supermileage/dynamometer-pcb/data/74HC4052/74HC4052.step

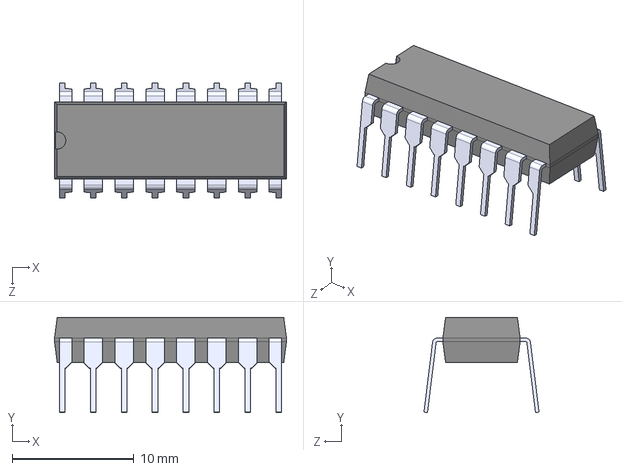
[picture p1: CAD file, 2023-05-04]
data/74HC4052/74HC4052.step
19.0 x 7.80 x 9.44 mm
