supermileage/dynamometer-pcb/data/LP11EE1NCSYG/LP11EE1NCSxx.stp

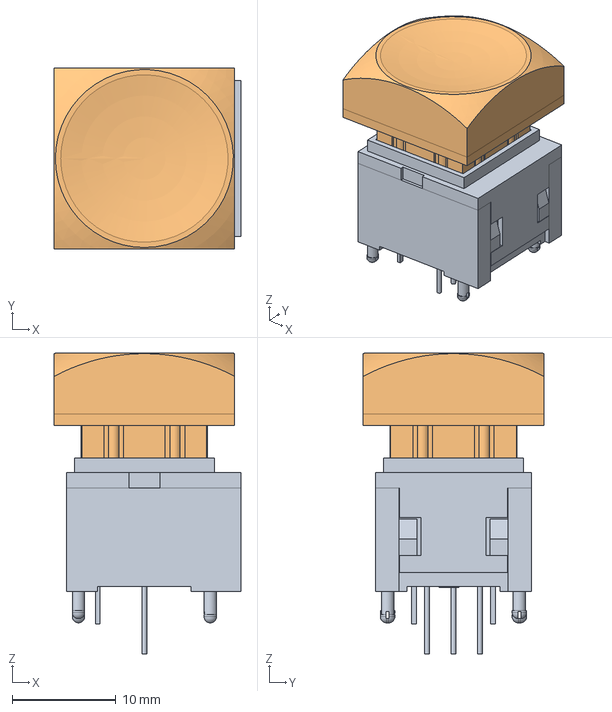
[picture p2: CAD file, 2023-02-23]
data/LP11EE1NCSYG/LP11EE1NCSxx.stp
18.0 x 17.4 x 29.0 mm
