supermileage/dynamometer-pcb/Dyno22.kicad_pcb

## KiCad design Dyno22.kicad_pcb (2024-02-17)

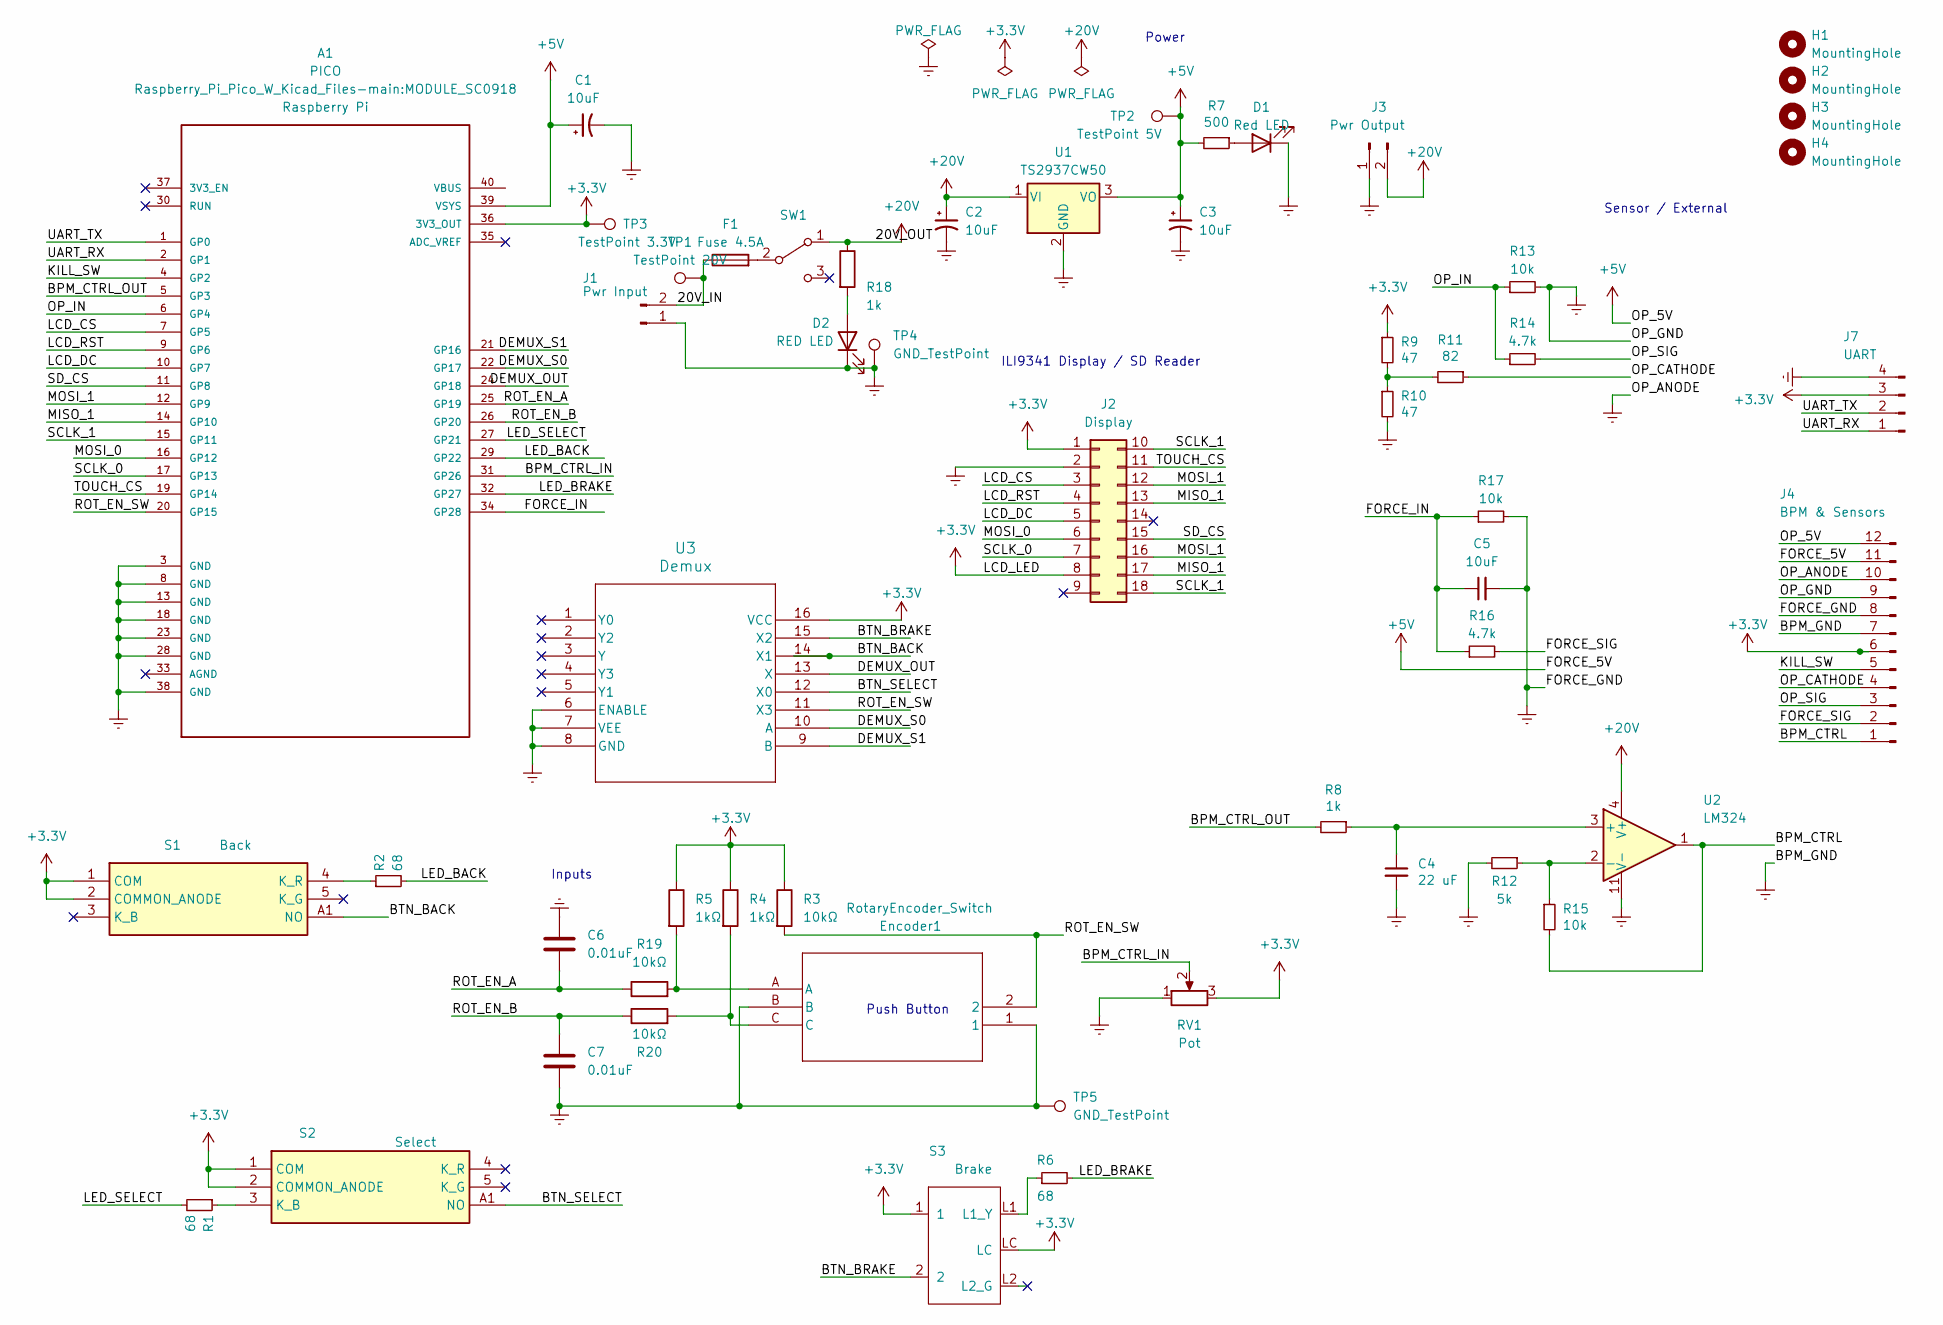
[picture p3: schematic Dyno22.kicad_sch]

Parts:
A1: PICO; MODULE_SC0918; PARTREV 1.6
C1, C3: 10uF; C_1206_3216Metric
C2: 10uF; CAP_293D-C_VSS
C4: 22 uF; C_0805_2012Metric
C5: 10uF; C_0805_2012Metric
C6, C7: 0.01uF; C_0603_1608Metric
D1: Red LED; LED_0805_2012Metric
D2: RED LED; LED_0805_2012Metric
Encoder1: RotaryEncoder_Switch; TO_215F-S0024
F1: Fuse 4.5A; Fuse_1206_3216Metric
H1, H2, H3, H4: MountingHole; MountingHole_3.2mm_M3
J1: Pwr Input; Molex_Nano-Fit_105313-xx02_1x02_P2.50mm_Horizontal
J2: Display; ILI9351_Large_Display
J3: Pwr Output; Molex_Nano-Fit_105313-xx02_1x02_P2.50mm_Horizontal
J4: BPM & Sensors; Molex_Nano-Fit_105314-xx12_2x06_P2.50mm_Horizontal
J7: UART; Molex_Nano-Fit_105314-xx04_2x02_P2.50mm_Horizontal
R1, R2, R6: 68; R_0805_2012Metric
R3, R19, R20: 10kΩ; R_0805_2012Metric
R4, R5: 1kΩ; R_0805_2012Metric
R7: 500; R_0805_2012Metric
R8, R18: 1k; R_0805_2012Metric
R9, R10: 47; R_0805_2012Metric
R11: 82; R_0805_2012Metric
R12: 5k; R_0805_2012Metric
R13, R15, R17: 10k; R_0805_2012Metric
R14, R16: 4.7k; R_0805_2012Metric
RV1: Pot; Potentiometer_Vishay_148-149_Single_Vertical
S1: Back; KP0115ANBKG03RGBP3SJB; Mouser Part Number 633-5ANBKG03RGBP3SJB
S2: Select; KP0115ANBKG03RGBP3SJB; Mouser Part Number 633-5ANBKG03RGBP3SJB
S3: Brake; LP11EE1NCSYG
SW1: SW_DPST_x2; SW_300SP1J1BLKM2QE
TP1: TestPoint 20V; TestPoint_Plated_Hole_D2.0mm
TP2: TestPoint 5V; TestPoint_Plated_Hole_D2.0mm
TP3: TestPoint 3.3V; TestPoint_Plated_Hole_D2.0mm
TP4, TP5: GND_TestPoint; TestPoint_Plated_Hole_D2.0mm
U1: TS2937CW50; SOT-223-3_TabPin2
U2: LM324; DIP-14_W7.62mm
U3: Demux; SOIC-16WB_ONS

Connections:
+3.3V: A1.36 (3V3_OUT), J2.1, J2.8, J4.6, J7.3, R3.1, R4.1, R5.1, R9.1, RV1.3, S1.1 (COM), S1.2 (COMMON_ANODE), S2.1 (COM), S2.2 (COMMON_ANODE), S3.1, S3.LC, TP3.1, U3.16 (VCC); also elsewhere on the board
+5V: A1.39 (VSYS), C1.1, C3.1, J4.11, J4.12, R7.2, TP2.1, U1.3 (VO)
+24V: C2.1, J3.2, R18.1, SW1.1 (A), U1.1 (VI), U2.4 (V+); also elsewhere on the board
/20V_IN: F1.1, J1.2, TP1.1
/BPM_CTRL: J4.1, R15.2, U2.1
/BPM_CTRL_IN: A1.31 (GP26), RV1.2
/BPM_CTRL_OUT: A1.5 (GP3), R8.2
/BTN_BACK: S1.A1 (NO), U3.14 (X1); also elsewhere on the board
/BTN_BRAKE: S3.2, U3.15 (X2)
/BTN_SELECT: S2.A1 (NO), U3.12 (X0); also elsewhere on the board
/DEMUX_OUT: A1.24 (GP18), U3.13 (X)
/DEMUX_S0: A1.22 (GP17), U3.10 (A)
/DEMUX_S1: A1.21 (GP16), U3.9 (B)
/FORCE_IN: A1.34 (GP28), C5.1, R16.1, R17.1
/FORCE_SIG: J4.2, R16.2
/KILL_SW: A1.4 (GP2), J4.5
/LCD_CS: A1.7 (GP5), J2.3
/LCD_DC: A1.10 (GP7), J2.5
/LCD_RST: A1.9 (GP6), J2.4
/LED_BACK: A1.29 (GP22), R2.2
/LED_BRAKE: A1.32 (GP27), R6.2
/LED_SELECT: A1.27 (GP21), R1.2
/MISO_1: A1.14 (GP10), J2.13, J2.17
/MOSI_0: A1.16 (GP12), J2.6
/MOSI_1: A1.12 (GP9), J2.12, J2.16
/OP_CATHODE: J4.4, R11.1
/OP_IN: A1.6 (GP4), R13.1, R14.1
/OP_SIG: J4.3, R14.2
/ROT_EN_A: A1.25 (GP19), C6.2, R19.1
/ROT_EN_B: A1.26 (GP20), C7.1, R20.1
/ROT_EN_SW: A1.20 (GP15), Encoder1.2, R3.2, U3.11 (X3); also elsewhere on the board
/SCLK_0: A1.17 (GP13), J2.7
/SCLK_1: A1.15 (GP11), J2.10, J2.18
/SD_CS: A1.11 (GP8), J2.15
/TOUCH_CS: A1.19 (GP14), J2.11
/UART_RX: A1.2 (GP1), J7.1
/UART_TX: A1.1 (GP0), J7.2
Earth: A1.3 (GND), A1.8 (GND), A1.13 (GND), A1.18 (GND), A1.23 (GND), A1.28 (GND), A1.38 (GND), C1.2, C2.2, C3.2, C4.2, C5.2, C6.1, C7.2, D1.1 (K), D2.1 (K), Encoder1.1, Encoder1.B, J1.1, J2.2, J3.1, J4.7, J4.8, J4.9, J4.10, J7.4, R10.2, R12.2, R13.2, R17.2, RV1.1, TP4.1, TP5.1, U1.2 (GND), U2.11 (V-), U3.6 (ENABLE), U3.7 (VEE), U3.8 (GND); also elsewhere on the board
unnamed: D1.2 (A), R7.1
unnamed: D2.2 (A), R18.2
unnamed 40: Encoder1.A, R5.2, R19.2; also elsewhere on the board
unnamed 41: Encoder1.C, R4.2, R20.2; also elsewhere on the board
unnamed: R9.2, R10.1, R11.2
unnamed 43: R2.1, S1.4 (K_R); also elsewhere on the board
unnamed 44: R1.1, S2.3 (K_B); also elsewhere on the board
unnamed: R6.1, S3.L1 (L1_Y)
unnamed 46: F1.2, SW1.2 (B); also elsewhere on the board
unnamed: C4.1, R8.1, U2.3 (+)
unnamed: R12.1, R15.1, U2.2 (-)

Notes on the sheet:
Power
Push Button
Sensor / External
ILI9341 Display / SD Reader
Inputs

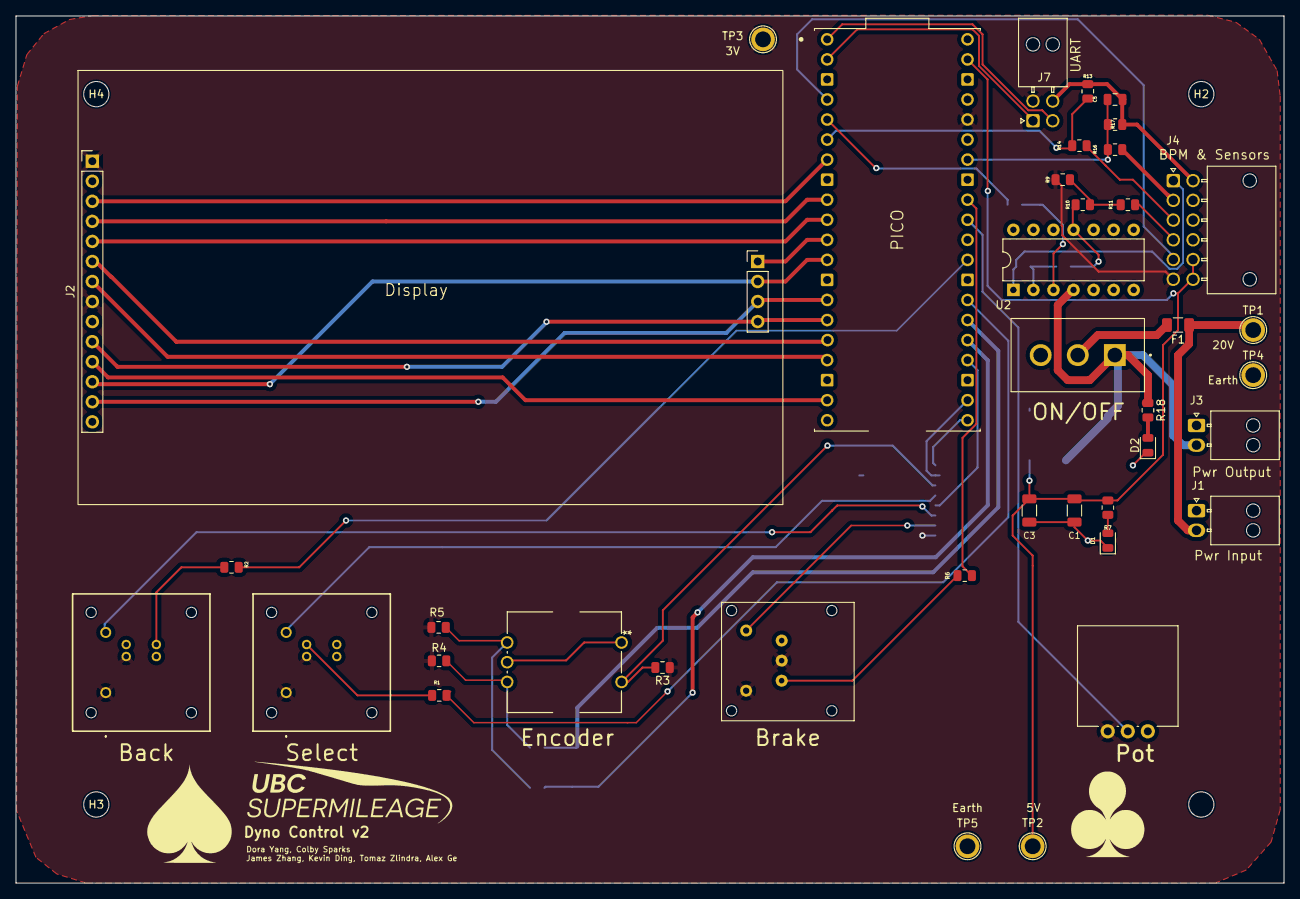
[picture p4: board Dyno22.kicad_pcb from above]

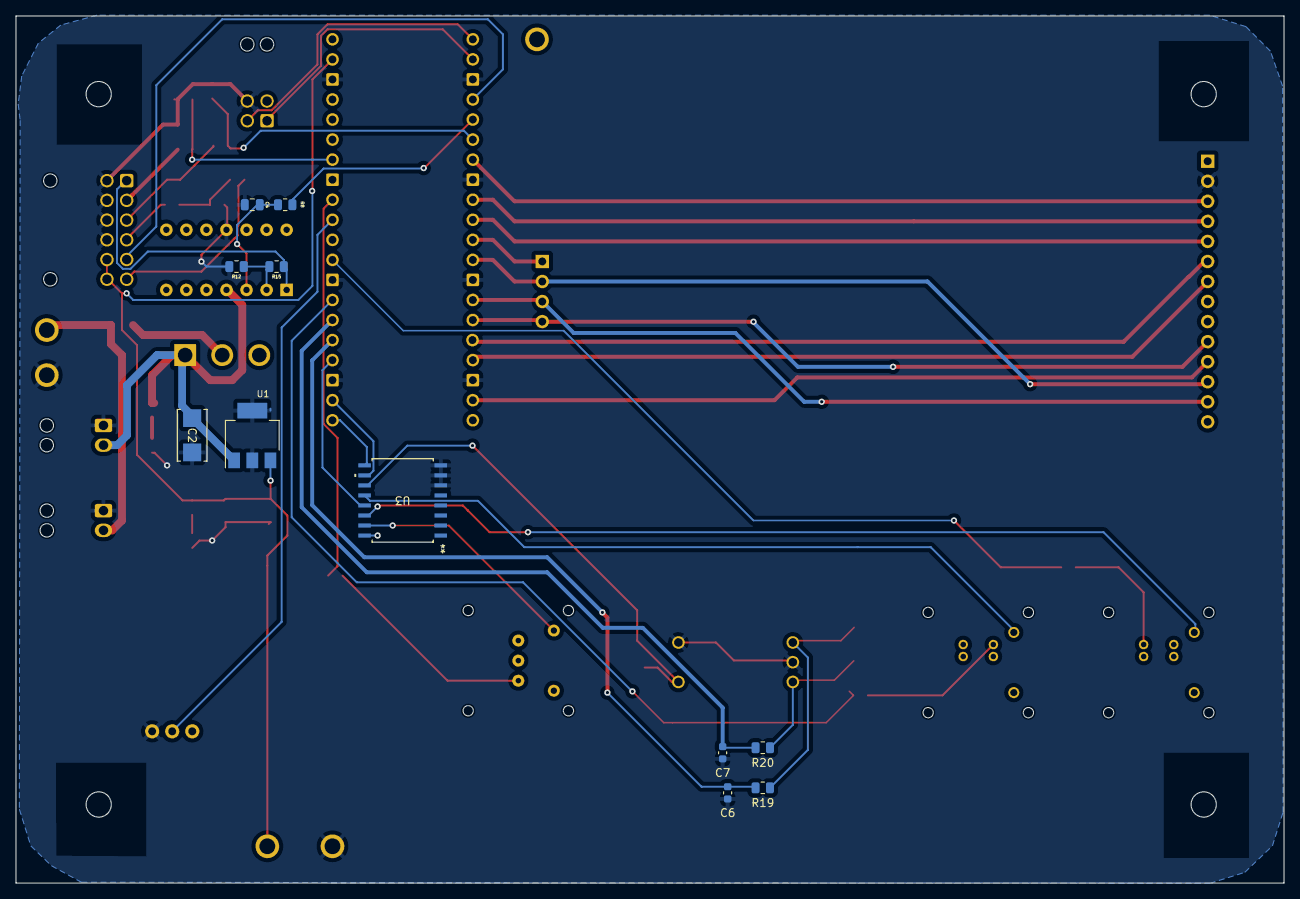
[picture p5: board Dyno22.kicad_pcb from below]

Board: 2 copper layers, 160.7 x 109.9 mm, 55 parts (11 on the bottom side), 49 nets.

Other parts of the board:
Back: Back; KP0115ANBKG03RGBP3SJB
Encoder: RotaryEncoder_Switch; TO_215F-S0024
GW: LOGO
ON/OFF: SW_DPST_x2; SW_300SP1J1BLKM2QE
Select: Select; KP0115ANBKG03RGBP3SJB

Their connections:
+3.3V: Back.1 (COM), Back.2 (COMMON_ANODE), Select.1 (COM), Select.2 (COMMON_ANODE); also elsewhere on the board
+24V: ON/OFF.1 (A); also elsewhere on the board
/BTN_BACK: Back.A1 (NO); also elsewhere on the board
/BTN_SELECT: Select.A1 (NO); also elsewhere on the board
/ROT_EN_SW: Encoder.2; also elsewhere on the board
Earth: Encoder.1, Encoder.B; also elsewhere on the board
unnamed 40: Encoder.A; also elsewhere on the board
unnamed 41: Encoder.C; also elsewhere on the board
unnamed 43: Back.4 (K_R); also elsewhere on the board
unnamed 44: Select.3 (K_B); also elsewhere on the board
unnamed 46: ON/OFF.2 (B); also elsewhere on the board
