supermileage/dynamometer-pcb/(threads)

Thread 1 (2023-02-17):

Update Schematic for rpi pico w

cosparks, 2023-02-17:
Update old schematic with non replaced with symbol raspberry pi pico, which runs on 3.3V instead of 5V.

### Available Pins
- we need to use GP4, GP5 (for i2c), GP16-GP21 (ili), and GP10-15 (spi1)

### Outward-Facing Connectors
- 20V input (3.3V distributed to board, 10V to op-amp)
- 20V output
- BPM control-voltage 0-10V
- force sensor
- optical sensor pins
- i2c (pins GP4, GP5, 3v3 and GND)

### Internal
- GP16-21 for ILI9341 display (https://www.aliexpress.com/item/1005004226615977.html)
- GP10-14 for ILI9341 sd card reader
- pwm output to opamp (all pico GP pins have pwm)
- EC11 rotary encoder (any available pins)
- 3 buttons (2 https://www.digikey.ca/en/products/detail/e-switch/LP11OA1TCSYY/4028417 and one https://www.digikey.com/en/products/detail/e-switch/LP11EE1NCSYG/9771935)

cosparks, 2023-02-17:
[pico PIO instructions](https://rp2040pio-docs.readthedocs.io/en/latest/pio-programs.html)

cosparks, 2023-02-21:
This issue has been turned into a milestone

Closed 2023-05-19.

Thread 2 (2023-02-17):

Dyno Controller PCB

cosparks, 2023-02-17:
## Layout
### Major component sizes
- ILI3941 Display is 55.04 x 89.3mm
- Latching button is 16.8 x 15mm
- Non-latching buttons are 15 x 15mm
- Rotary encoder is 11.7 x 11.7mm
- *proposed pcb dimensions*: 100 x 150mm

### Outward-Facing Connectors (from #1)
- All located at back (top edge) of board
- Screen SD card slot must be exposed, so display must also be aligned with top edge of board
- Force and optical sensor pins can be combined in one connector, rest can be separated (BPM control, i2c, 20V output)
- rpi pico w should be placed such that its usb connector is accessible either from the front, or front left/right corner of the board (see [urban steering PCB](https://github.com/supermileage/UrbanSteeringPCB) for reference)

### UI
- buttons can be placed in whichever way makes the most sense: I was thinking that the two non-latching buttons should be to the left of the rotary encoder, and the one latching button could be to the right
- *Note*: it's possible that this configuration may change: we might add more buttons

Closed 2023-05-19.

Thread 3 (2023-02-17):

Dyno Controller Case

cosparks, 2023-02-17:
### Details
- parametric dyno controller case using fusion360
- slight tilt from front of case to back
- *PCB dimensions*: 100 x 150 mm
- clear acrylic layer on top with holes for touch-screen display, rotary encoder and buttons

Closed 2023-05-19.

Thread 4 (2023-02-21):

Test Force Sensor w/ 3.3V power supply

cosparks, 2023-02-21:
If it cannot operate at a lower power supply then we will have to scale 0.5-5V signal to 0.3-3.3V

cosparks, 2023-02-24:
Added voltage divider circuit to schematic.

Closed 2023-02-24.

Thread 5 (2023-02-21):

Test EC11 Rotary Encoder

cosparks, 2023-02-21:
Add rotary encoder circuit to dyno control board schematic

cosparks, 2023-03-05:
@dorayang I've assigned this to you.  can be finished next weekend

Closed 2023-05-19.

Thread 6 (2023-02-21):

Update Brake Power Module Circuit

cosparks, 2023-02-21:
We will switch to using 3.3V pwm signal from the pico.  Update BPM op-amp circuit if necessary

Closed 2023-02-22.

Thread 7 (2023-02-21):

Update Optical Sensor Circuit

cosparks, 2023-02-21:
We can provide 5V output to OPB917, but OP_IN 5V logic level needs to be shifted to 3.3V

cosparks, 2023-02-21:
Added 4.7k -> 10k voltage divider circuit to schematic

Closed 2023-02-21.

Thread 11 (2023-02-24):

Find suitable potentiometer

cosparks, 2023-02-24:
Buttons and rotary encoder have height of ~24mm and base of 15x15mm.  Find a potentiometer with similar dimensions.  And link its footprint to the potentiometer in the schematic

cosparks, 2023-02-24:
this high-torque potentiometer looks ideal but is a bit expensive

https://www.digikey.ca/en/products/detail/vishay-sfernice/P11H1F0GHFW10103MA/16032840

cosparks, 2023-02-24:
very cheap, but low torque option:

https://www.digikey.ca/en/products/detail/bourns-inc/PTV09A-4220F-B103/3781150

Closed 2023-05-19.

Thread 12 (2023-02-24):

Remove pull-down resistors from buttons

cosparks, 2023-02-24:
rp2040 has optional pull-up and pull-down resistors on each gpio pin, so there is no need for pull-down resistors.

Closed 2023-05-19.

Thread 14 (2023-05-19):

Fix Rotary Encoder Footprint

cosparks, 2023-05-19:
Rotary encoder footprint for v1.0 is too small
- pin spacing is smaller than 2.54mm and courtyard diameter is off by ~5mm
- either redesign dyno control board with new footprint, or mini rotary encoder adapter for current footprint

cosparks, 2023-08-11:
We have additional rotary encoders which aren't already soldered into breakout boards.  I think they would require some pull-up resistors but that is it.  This is worth investigating as they are cheaper than the breakout board ones.

Closed 2023-11-11.

Thread 15 (2023-05-19):

Fix LCD Display Footprint

cosparks, 2023-05-19:
LCD does not fit perfectly in its socket header.  SD Card Header needs to be moved ~0.5mm down (towards rotary encoder) from current placement.  The pins/screen have some flexibility so the display does fit into the headers, but it could be improved.

cosparks, 2023-05-26:
I'm actually no so sure of this.  The second LCD I plugged into the board did not have to be contorted in any way to get it to fit, so it could have been an issue with the first display I tried to plug in.

Closed 2023-10-03.

Thread 16 (2023-05-19):

Consecutive pins for rotary encoder

cosparks, 2023-05-19:
Unfortunately, only neighbouring (consecutive pins) can be used for the pico's rotary encoder input.
- for PCB v2.0 ROT_EN_A and ROT_EN_B need to be consecutive

JamesZhZhang, 2023-10-28:
Note to self that the pin assignments in the firmware will have to change too

cosparks, 2023-10-28:
the current display driver that this project uses already makes use of the second pio module (I switched to that new driver this summer), so pio is no longer an option for rotary encoder.  Fortunately, it runs very smoothly from the main control loop so shouldn't need its own pio module.

That's not to say that the pins shouldn't be made consecutive, just to leave the option open in case rotary encoder performance deteriorates as the firmware grows in complexity and you decide at some point in the future reclaim that pio module.

JamesZhZhang, 2023-11-04:
Thanks for the reply @cosparks! I'm just having trouble interpreting what you mean, as I'm still trying to wrap my head around the codebase as a whole. What's the difference between the second pio module, and the main control loop here?

cosparks, 2023-11-05:
The rp2040 (mcu for rpi pico) has 2 programmable input/output modules which run independently of the main processor cores (although they run on the same clock).  [Here's](https://www.raspberrypi.com/news/what-is-pio/) a simple tldr.  More info in chapter 3 of the [rp2040 datasheet](https://datasheets.raspberrypi.com/rp2040/rp2040-datasheet.pdf).

Essentially, they allow you to write small programs (4 states each, and up to 32 assembly instructions per state) which can read and write to IO pins, and which can read and write data from the main cores using pico SDK functions.  You could write a PIO program which implements SPI, UART, CAN or some other communication protocol, for instance.

A really simple example would be the encoder program I wrote to count pulses the optical sensor pin [here](https://github.com/supermileage/dynamometer-firmware/blob/dev/src/PIO/pio_counter.pio), (which compiles to [this](https://github.com/supermileage/dynamometer-firmware/blob/dev/src/PIO/pio_counter_program.pio.h)).  You can see how we request data from that module in `SensorOptical::handle` [here](https://github.com/supermileage/dynamometer-firmware/blob/be151549e00a9ec12d626ddecfb0c235b8330257/src/Sensor/SensorOptical.cpp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).

The original plan was to use one module to read the optical sensor, and the other to handle the rotary encoder.  It was a mistake that the pins on the rotary encoder weren't placed consecutively, but this summer I switched from our old tft display driver to a new one which uses the second PIO module, so both have been claimed!  At least for now

JamesZhZhang, 2023-11-07:
Thanks for the explanation! I understand the implentation of the PIO now 😄

Just wanted to clarify what's currently implemented in the code. So the rotary encoder uses pins on the pico that correspond to the main control loop (i.e. no changes need to be made to the code, unless I change the pin assignments of the rotary encoder on the PCB?)

cosparks, 2023-11-07:
> Just wanted to clarify what's currently implemented in the code. So the rotary encoder uses pins on the pico that correspond to the main control loop

yep!  the rotary encoder pins are being handled by the input manager in the main control loop.

The decision on whether or not to change those pins is up to you, but I'd recommend it.  It would be a very small change in the code and would make the design a bit more flexible in case things change in the future

cosparks, 2023-11-07:
oops didn't mean to press close with comment haha

JamesZhZhang, 2023-11-07:
Gotcha, thanks so much for taking the time to explain all this to me! I'll go forward with making the pins consecutive for now, and probably add a comment in the code for the rotary encoder pin assignment for future reference. Best of luck with your capstone!

Closed 2024-01-21.

Thread 17 (2023-05-20):

Fix potentiometer footprint

cosparks, 2023-05-20:
The through-holes on the right side of footprint are too far apart vertically.  It seems like they should be within the bounds of, and not centred at the corners of the courtyard.
- holes probably need to be brought in ~1mm towards the center of the courtyard

The potentiometer's mounting supports can be bent so that they fit the current design, so this is not a deal-breaker

KevinZhiyuanDing, 2023-10-28:
https://github.com/supermileage/dynamometer-pcb/commit/03d35e74a3f1db1f3750efc926a0eced5b3e5ced

cosparks, 2023-10-28:
@KevinZhiyuanDing I still get notifications for this repo so saw that you are working on this.

I forgot to add that the potentiometer footprint also should be rotated 90° counter-clockwise, so the nob sits in the correct position when it's zeroed.  I'm not sure if knobs for d-shaft pots are standardized, but all the ones that I checked out at lee's electronics were the same.

this is zero (closed)
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
but this should be zero:
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

And to fully open the pot you rotate clockwise 270°

Closed 2023-11-11.

Thread 18 (2023-05-20):

Increase size of silkscreen labels for buttons and connectors

cosparks, 2023-05-20:
- current size is only legible from very close -- should be double or triple the current size

KevinZhiyuanDing, 2023-11-18:
Label dimensions for buttons and connectors changed for height and width
from 1.0 mm to 1.5 mm
or
from 0.8 mm to 1.2mm

Closed 2024-02-12.

Thread 19 (2023-05-21):

More space for potentiometer

cosparks, 2023-05-21:
With everything mounted on the board, it is apparent that the spacing of the potentiometer and brake button isn't optimal.
- sensor caps and resistors can be moved to bottom of board to bottom of board
- bottom-right silkscreen label can be moved and pico can farther down in the bottom right corner

KevinZhiyuanDing, 2023-11-18:
@cosparks I moved the potentiometer down and the rotary encoder to the right slightly to make it less cramped. Could you clarify how the Pico can be moved further down because there is a mounting point in the way. Here are the changes I made so far:
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
I also increased the text label size on the silk screen.
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

cosparks, 2023-11-18:
looks awesome!  You could move the pico down a tiny bit without moving that mounting hole, or you could move the mounting hole so it sits to the left of the pico and move the pico all the way down so it's almost flush with the corner.  The second option would require a small redesign to the case.

Aesthetically, neither option is great, as the buttons and rotary encoder will no longer be aligned with the pico, but that probably doesn't matter that much

cosparks, 2023-11-18:
If it's going to be out of alignment anyways, I think I would prefer the second option.

LaPommeCosmique, 2023-11-20:
That makes sense. Just wondering, what would you say would be an acceptable distance for the potentiometer and the brake button? Its harder for me to visualize everything mounted on the board as we don't have a potentiometer knob.

cosparks, 2023-11-20:
It kinda looks like the brake button should come down maybe a couple millimetres, and then the potentiometer should be centred between it and the pico.  Currently it's 11m between pot and brake button, but I'd add at least 4mm so there is >=15mm between the two.

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

cosparks, 2023-11-20:
I should really drop off this board and case so you guys have it

LaPommeCosmique, 2023-11-20:
I see what you mean now. I wonder if we can just remove the brake button all together, and replace the potentiometer with one that has a click at 0. Aesthetically there's less clutter and I don't think we lose any functionality. We can also have something like an LED that signals whether the brake is receiving power.

cosparks, 2023-11-20:
A couple thoughts on that.
1. It's nice to have a latching button for UI stuff: brake button is already being used for editing filenames in the text dialog editor (in this context, it performs the same function as the rotary encoder switch, but I've found it's a much nicer option because holding down the encoder switch to edit characters is kind of annoying).  I don't think a potentiometer switch would be as intuitive or useful
2. It might be hard to find a high-torque option with a switch (although I'm not sure whether or not you still want a high torque potentiometer on board)

Closed 2024-01-21.

Thread 20 (2023-07-09):

Add on/off switch to board

cosparks, 2023-07-09:
Among other things, an on/off switch would make it easier to reset the controller.

Add to back or side.  Make sure it aligns with the case.

KevinZhiyuanDing, 2023-11-18:
@cosparks Hey Colby, would it be okay if we implement the switch externally instead of on the board itself, adding an on off switch between the power source and the power input.

cosparks, 2023-11-18:
> @cosparks Hey Colby, would it be okay if we implement the switch externally instead of on the board itself, adding an on off switch between the power source and the power input.

that sounds like a very good solution!

cosparks, 2023-11-18:
Only advantage that I can think of for having it on the board is that it would be more accessible, and could be used with any power supply.

KevinZhiyuanDing, 2023-11-25:
Ok thanks. Alex, James and I are weighting the options

Closed 2024-01-21.

Thread 23 (2023-11-26):

Move LCD pins and PICO pins closer together

JamesZhZhang, 2023-11-26:
Sara mentioned that theres a large number of traces going from the LCD to the PICO, and cover a large distance. This is effectively splitting the front copper plane. She recommended moving the LCD down (where the buttons and rotary encoder are) and also flipping it so the SD reader can be aligned with a face. She also recommended Moving the PICO to be more central

cosparks, 2023-11-26:
Note that the SD card slot in the LCD screen needs to remain accessible through the slit that I added to the dyno controller case.
The pico micro-usb connector also needs to be accessible so you can plug in through the side of the case (the original plan was to have an acrylic cover with button, potentiometer and rotary encoder holes cut: with this cover on, the pico wouldn't be accessible from the middle of the board).

It looks like there is a lot of room for stuff on the back copper, so you could instead add vias and run the traces along the back copper for part of their path.  Then you wouldn't have to rearrange anything.

cosparks, 2023-11-26:
> also flipping it so the SD reader can be aligned with a face.

The SD reader is aligned with the back face of the case

JamesZhZhang, 2023-11-26:
Yup we'll account for the SD card reader and PICO micro usb slot being on the edge of the board. We'll likely be making small modifications to the case and re-printing it if we go through with these changes. To centralize the PICO, we were thinking of possibly rotating it 90 degrees such that the micro usb is facing the top or bottom edge.

The reason why Sara wants to move the LCD and PICO closer is because the traces are effectively cutting the front copper in half right now. We'd see the same issue if we moved the traces to the back copper. Ideally we want the majority of traces to be as short as possible.

Closed 2024-01-21.

Thread 24 (2023-11-26):

Changes Trace for Quality of Life

JamesZhZhang, 2023-11-26:
Ensure there are no right angles and no junctions in the traces. Also ensure there are no large deadzones created by the traces

Closed 2024-02-12.

Thread 25 (2023-11-26):

Change Component Slikscreens

JamesZhZhang, 2023-11-26:
Change silkscreens such that it's only the designator (R1) and not the value (1k ohm), unless necessary to have the value.

Make sure designator silkscreens are outside the component footprint (so that the designator is still visible when the component is mounted

Closed 2024-02-17.

Thread 26 (2023-11-26):

Add Keep Out Zones for Mounting Holes

JamesZhZhang, 2023-11-26:
Add keep out zones for mounting holes. This is to prevent an electrical short from mounting with metal screws (currently we use plastic screws)

Closed 2024-01-21.

Thread 27 (2023-11-26):

Quality of Life Changes for Power

JamesZhZhang, 2023-11-26:
Add a fuse for the 24V line.

Add LEDs for the power lines to indicate power is flowing. (May also need to add a resistor for the diode)

Add 4 testpoints for 24V, 5V, 3.3V, EARTH. Recommended to be 4mm surface mount rectangular test points.

Closed 2024-01-21.

Thread 29 (2024-03-16):

Power PI Pico with 5V makes it output on VSYS and powers the entire 20V trace with 5V

LaPommeCosmique, 2024-03-16:
Power PI Pico with 5V makes it output on VSYS and powers the entire 20V trace with 5V.

As a result, the 20V LED turns on the pico is receiving power from the microUSB cable, even when there is no 20V supply going into the board.

Could add a diode or something here (suggested by @JamesZhZhang )

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

JamesZhZhang, 2024-03-16:
Following the datasheet, adding Schottky diode 'D' should fix this
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

Someone just needs to spec the correct Schottky diode based on the voltages here

(From pg 21 of pi pico datashewet https://datasheets.raspberrypi.com/pico/pico-datasheet.pdf)
