supermileage/dynamometer-pcb/(commit log)

2023-02-12 Adding Dyno KiCad Project Files
    [Dyno22.kicad_pcb, Dyno22.sch]
2023-02-21 Updates schematic to include pico w, lcd display and ui inputs
    [Dyno22.kicad_pcb, Dyno22.kicad_sch]
2023-02-21 Fixes some labels--adds new label for 20V input
    [Dyno22.kicad_sch]
2023-02-21 Adds 5 -> 3.3V conversion for force and optical sensors
    [Dyno22.kicad_sch]
2023-02-21 Adds voltage regulator to power input
    [Dyno22.kicad_sch]
2023-02-21 Adds connections for all button pins
    [Dyno22.kicad_sch]
2023-02-21 Fixes pin headers for lcd display
    [Dyno22.kicad_sch]
2023-02-22 Modifies op amp circuit -- 3.3V -> 10V pwm
    [Dyno22.kicad_sch]
2023-02-22 uart labels assigned to wrong pins
    [Dyno22.kicad_sch]
2023-02-23 Adds graphics to pcb
    [Dyno22.kicad_pcb, Dyno22.kicad_sch, LP11EE1NCSxx.stp]
2023-02-23 Adds wider traces and high-voltage capacitor to pwr circuit
    [Dyno22.kicad_pcb, Dyno22.kicad_sch]
2023-02-23 Rearranges components on pcb - final arrangement
    [Dyno22.kicad_pcb]
2023-03-11 Uploading changes to PCB and Schematic
    * Removed button pull down resistors
    * Updated rotary encoder and potentiometer footprints
    * Moved display (and minor layout changes of other components)
    * Added mounting holes to support rotary encoder
    [Dyno22.kicad_pcb, Dyno22.kicad_sch, Dyno22.sch]
2023-03-18 PCB Layout Done
    [Dyno22.kicad_pcb]
2023-04-08 PCB Update: new connectors, UART, e-stop, buttons moved
    [Dyno22.kicad_pcb, Dyno22.kicad_sch]
2023-04-08 Eliminated PCB design rule check errors
    [Dyno22.kicad_pcb, Dyno22.kicad_sch]
2023-05-04 adjusts positioning of buttons and screen -- adds names to silkscreen layer
    [Dyno22.kicad_pcb, Dyno22.kicad_sch]
2023-05-04 Adds project-local copies of newly added symbols and footprints
    [74HC4052.step, Dyno22.kicad_pcb, Dyno22.kicad_sch]
2023-05-04 Adds proper footprint for LM324
    [Dyno22.kicad_pcb, Dyno22.kicad_sch]
2023-10-28 Fix potentiometer footprint#17
2023-11-04 Fix Rotary Encoder Footprint #14
    [Dyno22.kicad_pcb, Dyno22.kicad_sch]
2023-11-11 Rerouted some traces for DRC and made ROT pins consecutive
    [Dyno22.kicad_pcb, Dyno22.kicad_sch]
2023-11-19 Changes the rotary encoder input pins, spacing adjustments to encoder and potentiometer, increase in silkscreen text size.
    [Dyno22.kicad_pcb, Dyno22.kicad_sch]
2023-11-25 Fixed traces DRC
    [Dyno22.kicad_pcb, Dyno22.kicad_sch]
2023-12-02 moving traces for the pot
    [Dyno22.kicad_pcb, Dyno22.kicad_sch]
2024-01-15 Schematic modifications, including additional switch, fuse and LED
    [Dyno22.kicad_sch]
2024-01-16 schematic changes v2
    [Dyno22.kicad_pcb, Dyno22.kicad_sch]
2024-01-18 moved LCD PICO, updated traces for buttons encoder pot
    [Dyno22.kicad_pcb, Dyno22.kicad_sch]
2024-01-19 moved components and fixed connections to accomodate for new pico location and power components
    [Dyno22.kicad_pcb, Dyno22.kicad_sch]
2024-01-20 made some passive components 0805 and changed some routing
    [Dyno22.kicad_pcb, Dyno22.kicad_sch]
2024-01-21 Added demux changed LED location changed some Rs
    [Dyno22.kicad_pcb, Dyno22.kicad_sch]
2024-01-25 Amplifier footprint changes
    [Dyno22.kicad_pcb, Dyno22.kicad_sch]
2024-01-27 Changed routing and component placement AGAIN
    [Dyno22.kicad_pcb]
2024-01-27 Forgot to save schematic changes
    [Dyno22.kicad_pcb, Dyno22.kicad_sch]
2024-01-27 Fix the earth, the earth is our home
    [Dyno22.kicad_pcb, Dyno22.kicad_sch]
2024-01-27 PCB trace routing changes
    [Dyno22.kicad_pcb]
2024-01-27 Trace changes
    [Dyno22.kicad_pcb]
2024-01-29 Through hole adjustments and some routing changes
    [Dyno22.kicad_pcb, Dyno22.kicad_sch]
2024-01-31 move around the rot encoder
    [Dyno22.kicad_pcb]
2024-02-03 updated encoder
    [Dyno22.kicad_pcb, Dyno22.kicad_sch]
2024-02-03 added encoder filter circuit
    [Dyno22.kicad_pcb, Dyno22.kicad_sch]
2024-02-04 eliminated demux dead zone
    [Dyno22.kicad_pcb]
2024-02-04 gerber output
    [Dyno22-B_Cu.gbl, Dyno22-B_Mask.gbs, Dyno22-B_Paste.gbp, Dyno22-B_Silkscreen.gbo, Dyno22-Edge_Cuts.gm1, Dyno22-F_Cu.gtl, Dyno22-F_Mask.gts, Dyno22-F_Paste.gtp]
